DiveTeam/battery/esp32_firmware/control/docs/Bluetooth-TTGO-wi-fi-wi-fi-ESP32-IPEX.jpg

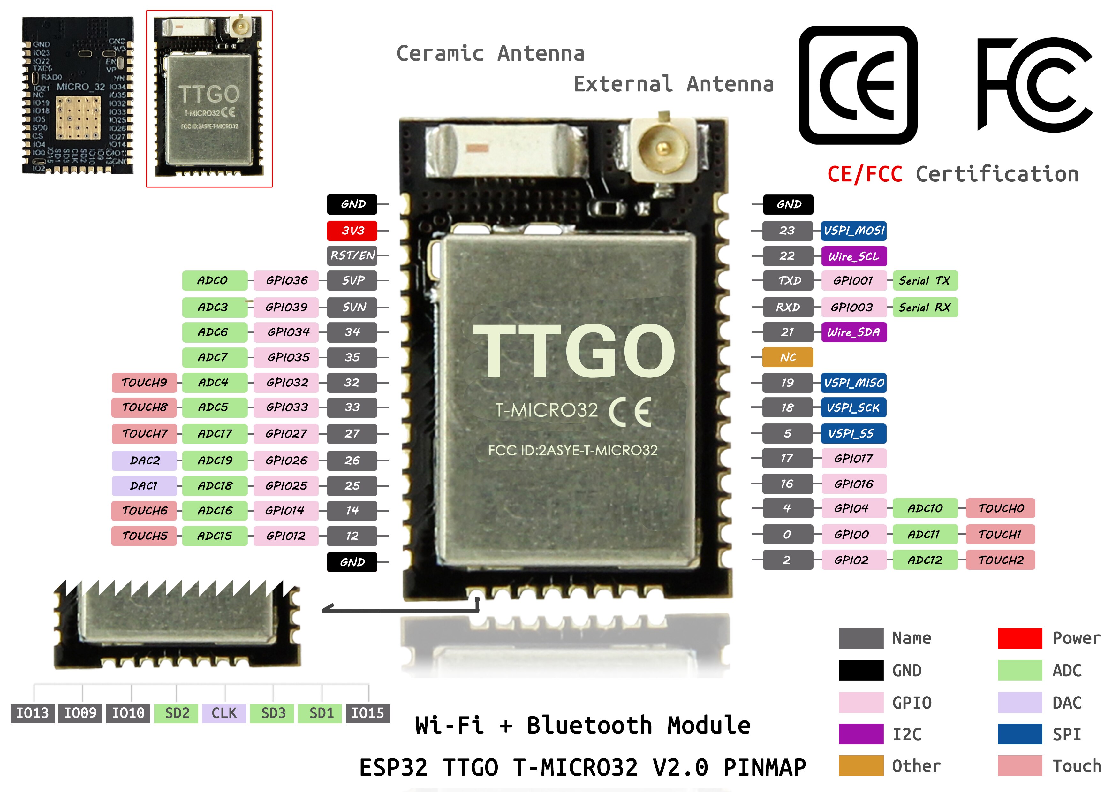
esp32_firmware/control/docs/Bluetooth-TTGO-wi-fi-wi-fi-ESP32-IPEX.jpg
