DiveTeam/battery/esp32_firmware/control/docs/ESP32_CH340G.png

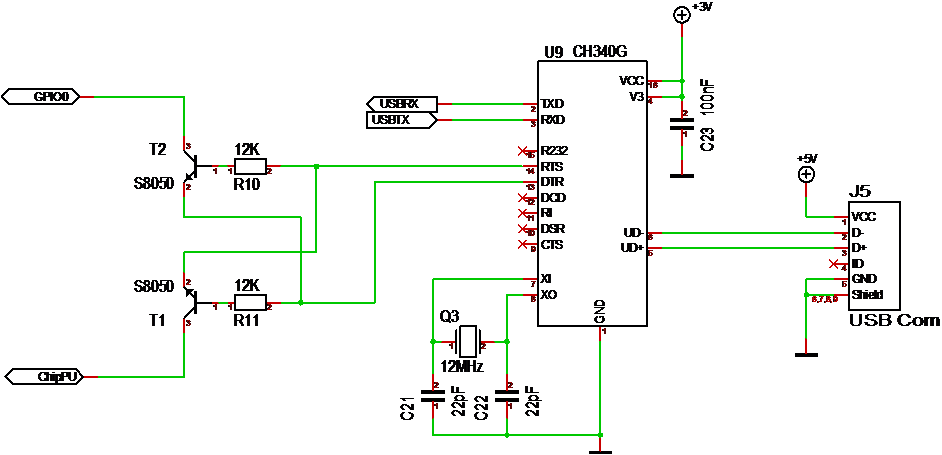
esp32_firmware/control/docs/ESP32_CH340G.png
