DiveTeam/battery/model/Батарея/батарея.SLDASM

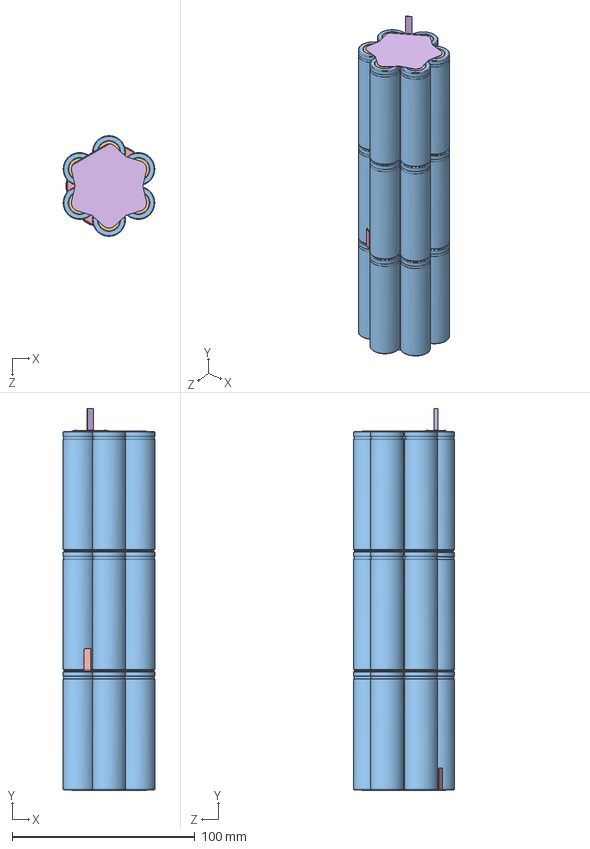
[picture p3: CAD file, 2020-10-05]
model/Батарея/батарея.SLDASM
50.0 x 208.8 x 55.0 mm
battery terminal - x 21
battery washer x 21
battery case x 21
battery terminal + x 21
контакт-1 x 5
контакт-2
