DiveTeam/battery/model/Гермоввод/гермоввод.SLDASM

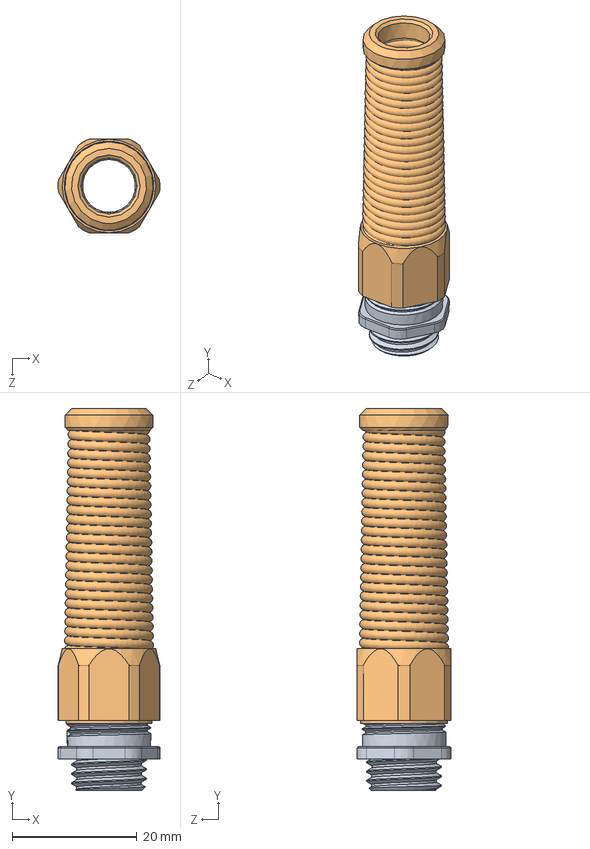
[picture p4: CAD file, 2020-10-05]
model/Гермоввод/гермоввод.SLDASM
16.4 x 61.2 x 15.0 mm
основание
гайка
