DiveTeam/battery/model/Кнопка/кнопка.SLDASM

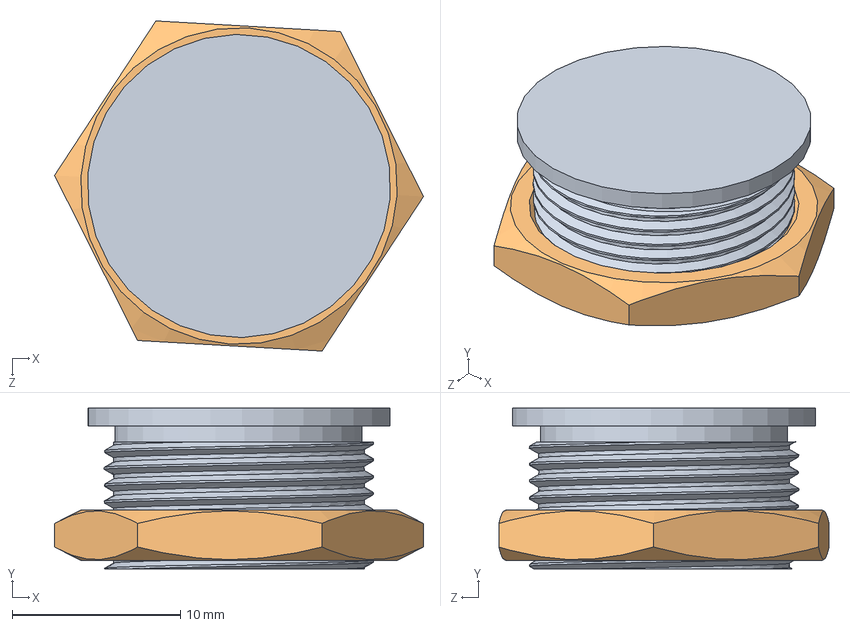
[picture p5: CAD file, 2020-10-05]
model/Кнопка/кнопка.SLDASM
21.9 x 9.55 x 19.6 mm
кнопка-корпус
кнопка-гайка
кнопка-заливка
