DiveTeam/battery/model/pan cross head_am.sldprt

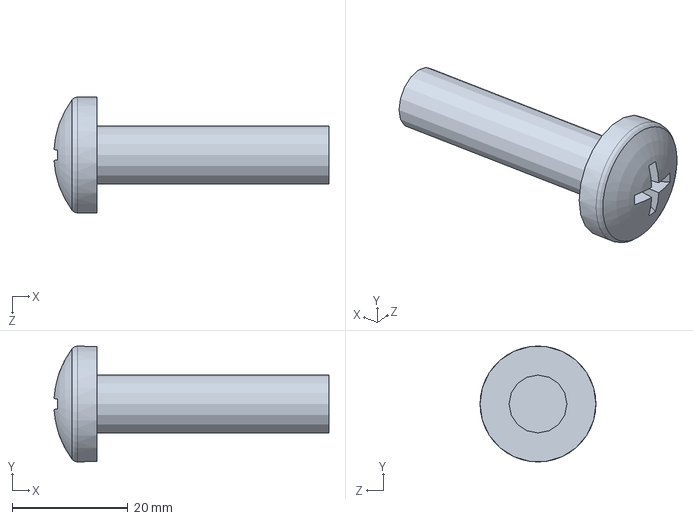
[picture p6: CAD file, 2020-10-05]
model/pan cross head_am.sldprt
47.4 x 20.0 x 20.0 mm
