DiveTeam/battery/model/Батарея/ncr18650b/battery terminal +.SLDPRT

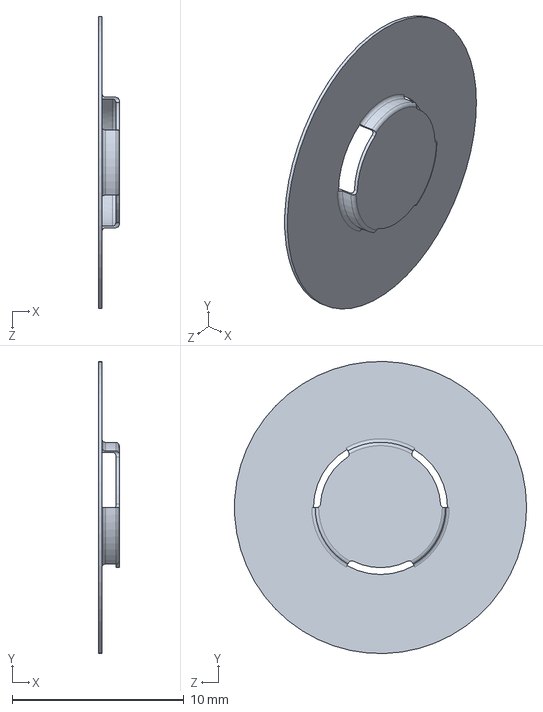
[picture p7: CAD file, 2020-10-05]
model/Батарея/ncr18650b/battery terminal +.SLDPRT
1.20 x 17.0 x 17.0 mm
