DiveTeam/battery/model/Батарея/контакт-2.SLDPRT

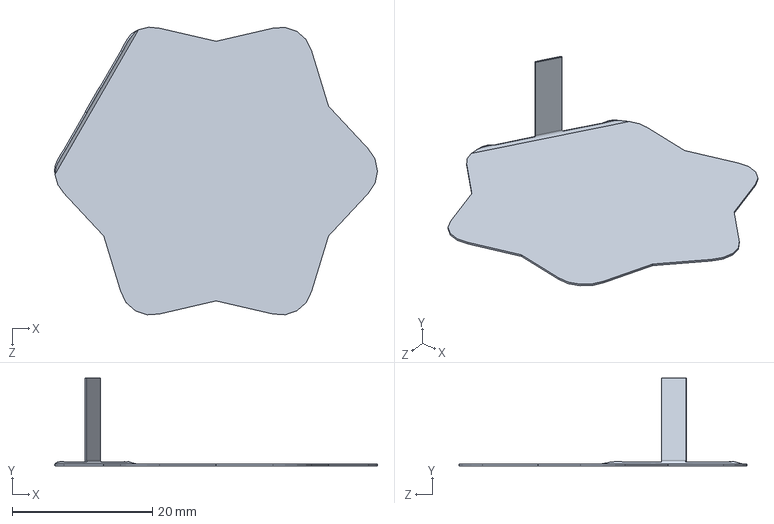
[picture p8: CAD file, 2020-10-05]
model/Батарея/контакт-2.SLDPRT
46.0 x 12.5 x 41.0 mm
