DiveTeam/battery/model/Гермоввод/гайка.SLDPRT

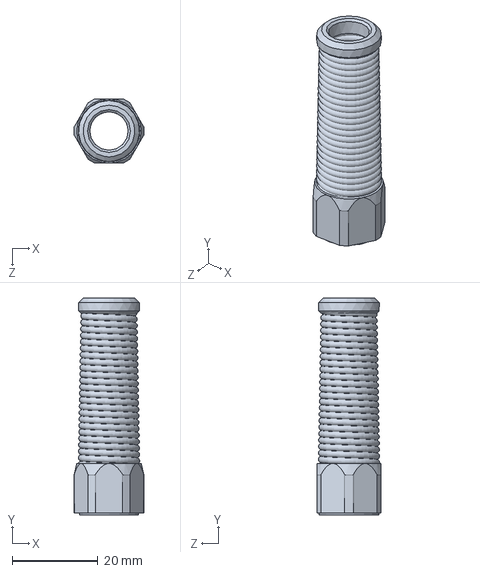
[picture p9: CAD file, 2020-10-05]
model/Гермоввод/гайка.SLDPRT
16.3 x 50.5 x 15.0 mm
