DiveTeam/battery/model/Кнопка/кнопка-корпус.SLDPRT

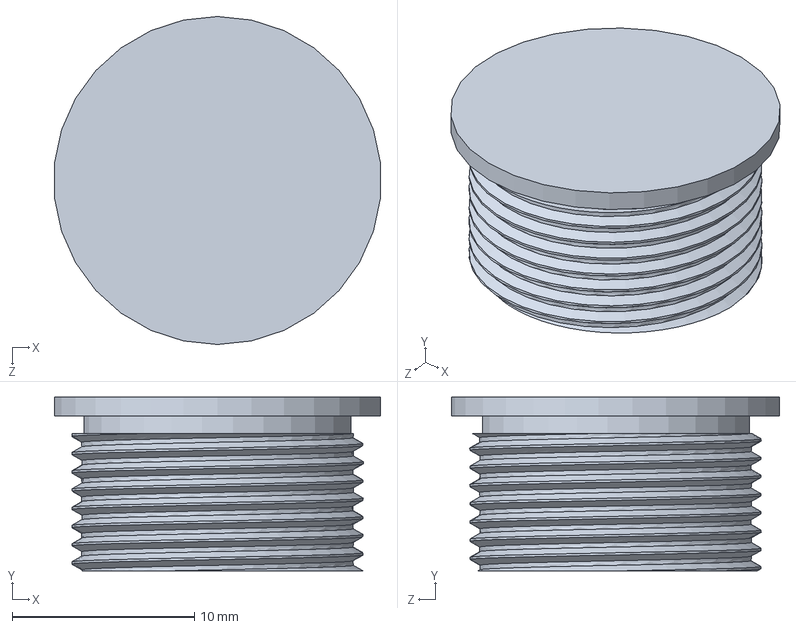
[picture p10: CAD file, 2020-10-05]
model/Кнопка/кнопка-корпус.SLDPRT
17.9 x 9.55 x 18.0 mm
