DiveTeam/battery/model/Крепёж/болт.SLDPRT

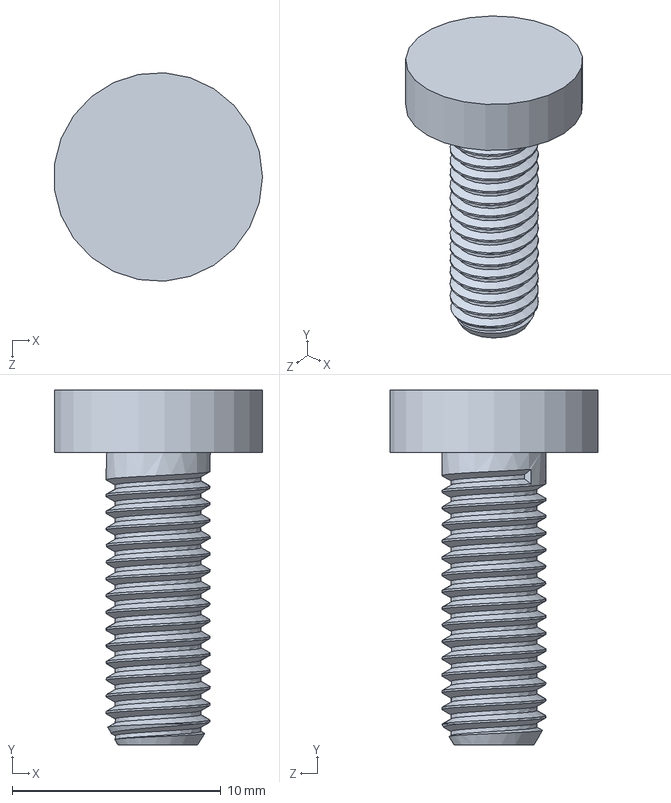
[picture p11: CAD file, 2020-10-05]
model/Крепёж/болт.SLDPRT
9.96 x 17.0 x 9.98 mm
