DiveTeam/battery/model/Пластик/нижняя крышка.SLDPRT

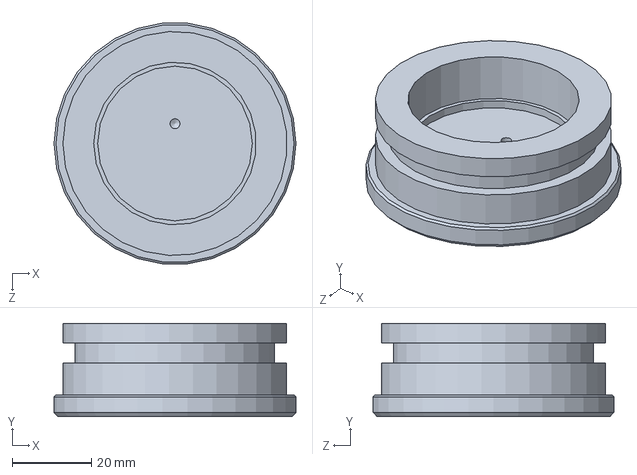
[picture p12: CAD file, 2020-10-05]
model/Пластик/нижняя крышка.SLDPRT
61.0 x 23.5 x 60.7 mm
