DiveTeam/battery/model/Платы/плата-кнопки.SLDPRT

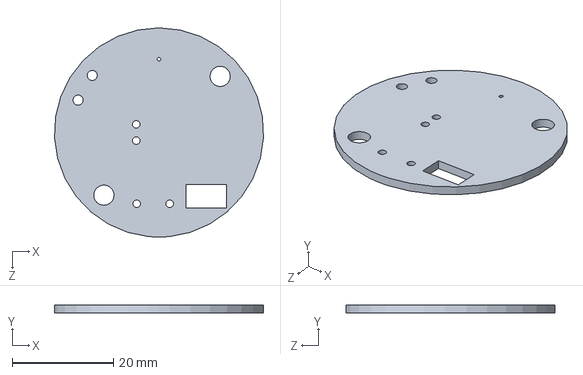
[picture p13: CAD file, 2020-10-05]
model/Платы/плата-кнопки.SLDPRT
41.3 x 1.60 x 41.4 mm
