DiveTeam/battery/model/EO-корд-корпус.SLDPRT

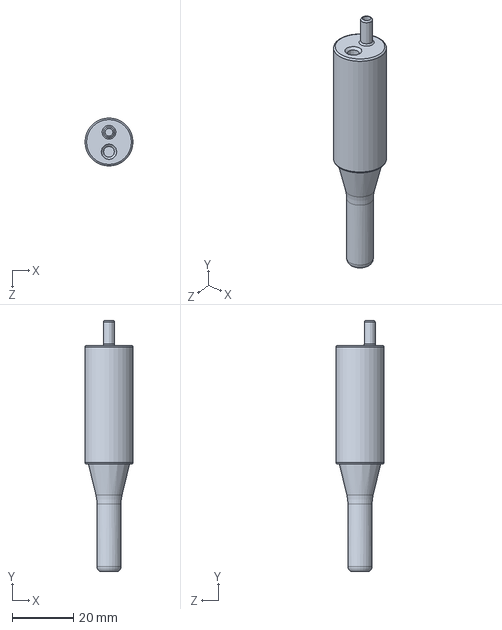
[picture p14: CAD file, 2020-10-05]
model/EO-корд-корпус.SLDPRT
15.6 x 81.7 x 15.6 mm
