DiveTeam/battery/model/Батарея/ncr18650b/battery case.SLDPRT

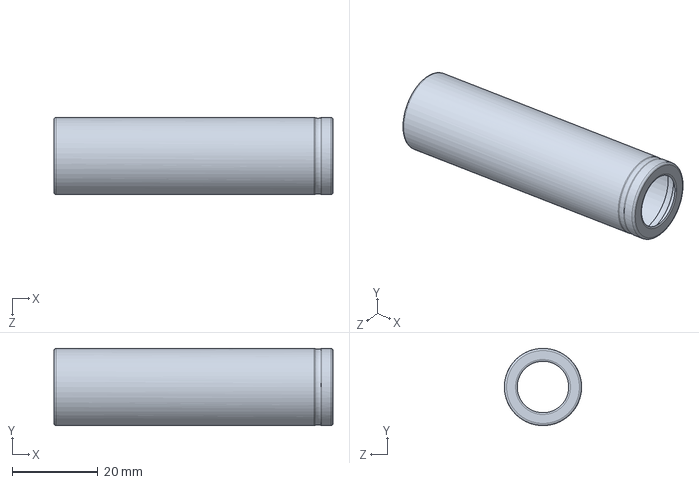
[picture p15: CAD file, 2020-10-05]
model/Батарея/ncr18650b/battery case.SLDPRT
65.0 x 18.0 x 18.0 mm
