DiveTeam/battery/model/Гермоввод/основание.SLDPRT

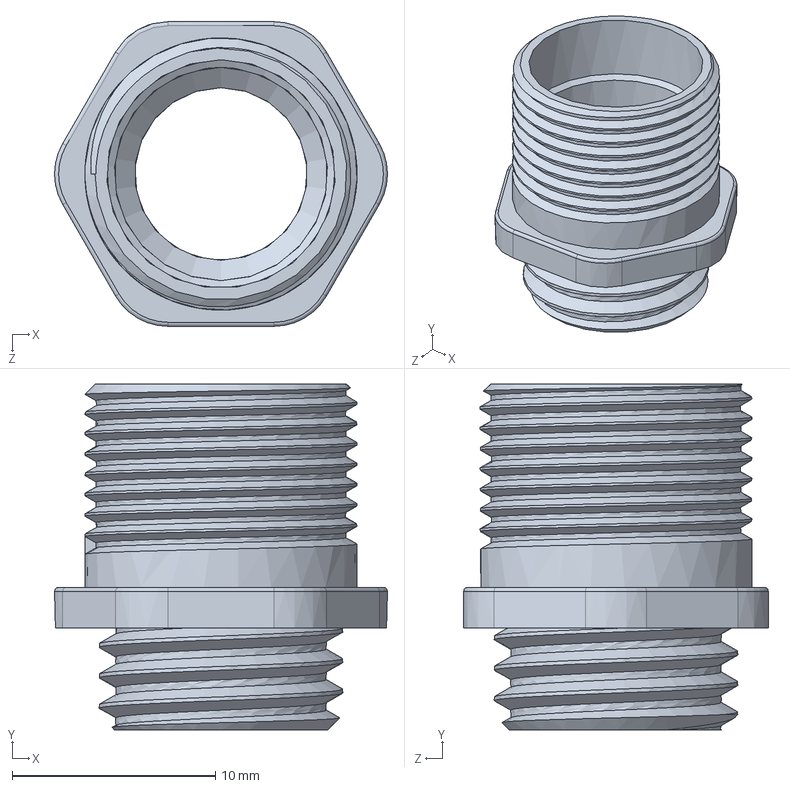
[picture p16: CAD file, 2020-10-05]
model/Гермоввод/основание.SLDPRT
16.4 x 17.0 x 15.0 mm
