DiveTeam/battery/model/Кнопка/кнопка-заливка.SLDPRT

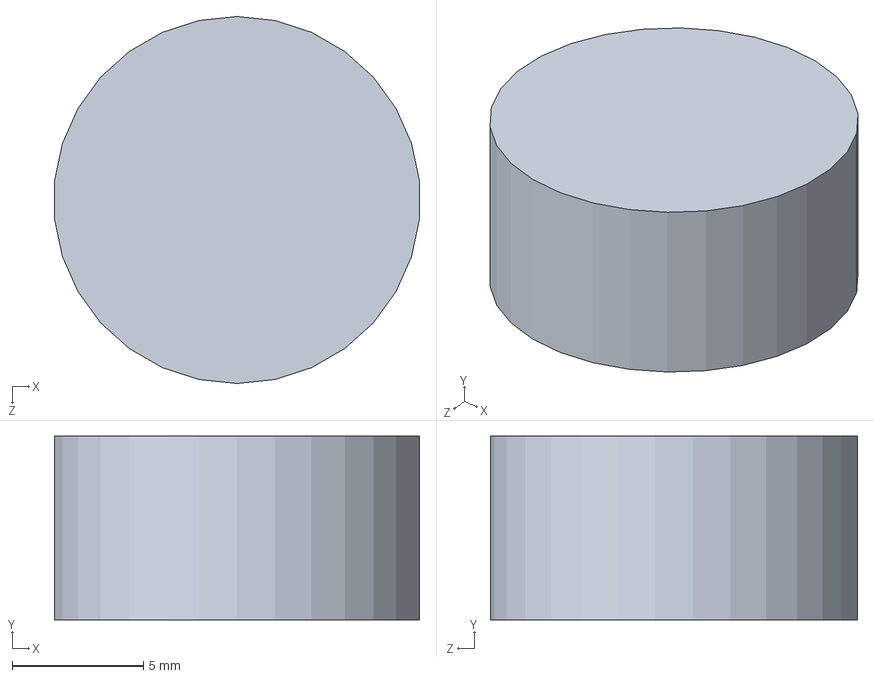
[picture p17: CAD file, 2020-10-05]
model/Кнопка/кнопка-заливка.SLDPRT
13.9 x 7.00 x 14.0 mm
