DiveTeam/battery/model/Крепёж/гужон.SLDPRT

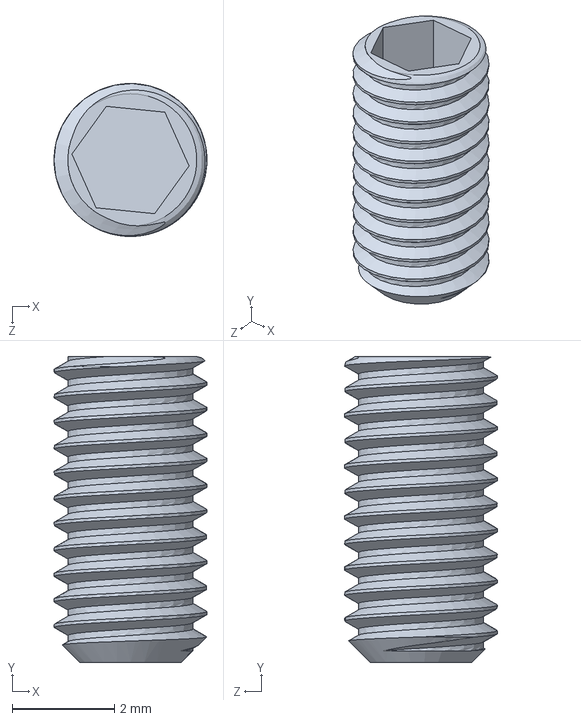
[picture p18: CAD file, 2020-10-05]
model/Крепёж/гужон.SLDPRT
3.00 x 6.00 x 3.00 mm
