DiveTeam/battery/model/Пластик/верхняя крышка.SLDPRT

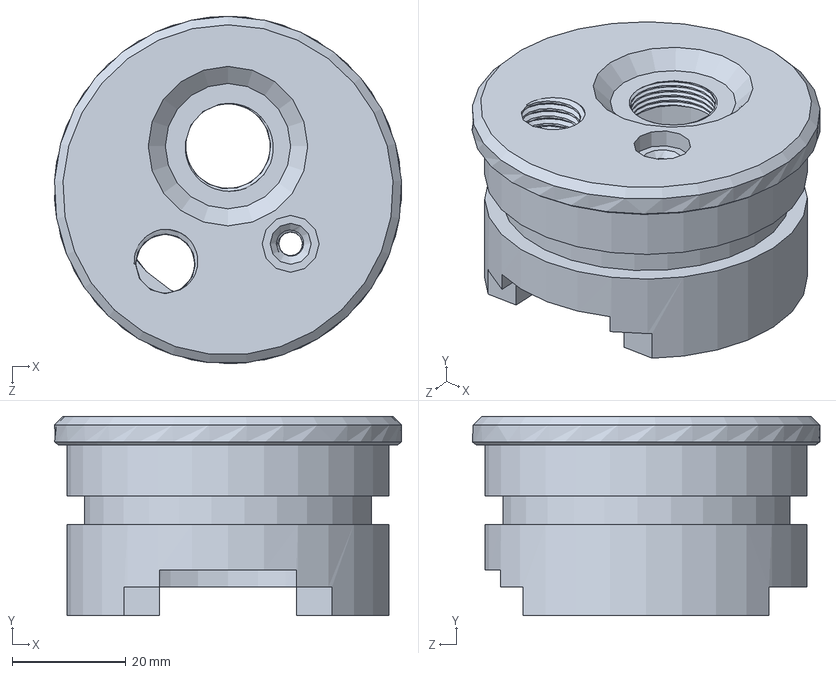
[picture p19: CAD file, 2020-10-05]
model/Пластик/верхняя крышка.SLDPRT
60.9 x 35.0 x 61.0 mm
