DiveTeam/battery/model/Платы/плата-защита.SLDPRT

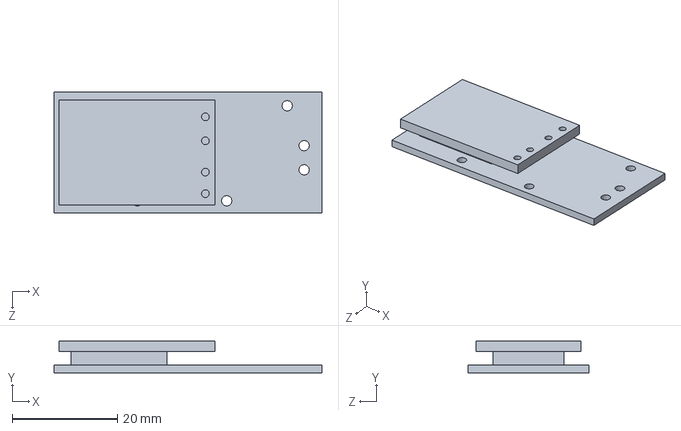
[picture p20: CAD file, 2020-10-05]
model/Платы/плата-защита.SLDPRT
51.0 x 6.00 x 23.0 mm
