DiveTeam/battery/model/Батарея/контакт-1.SLDPRT

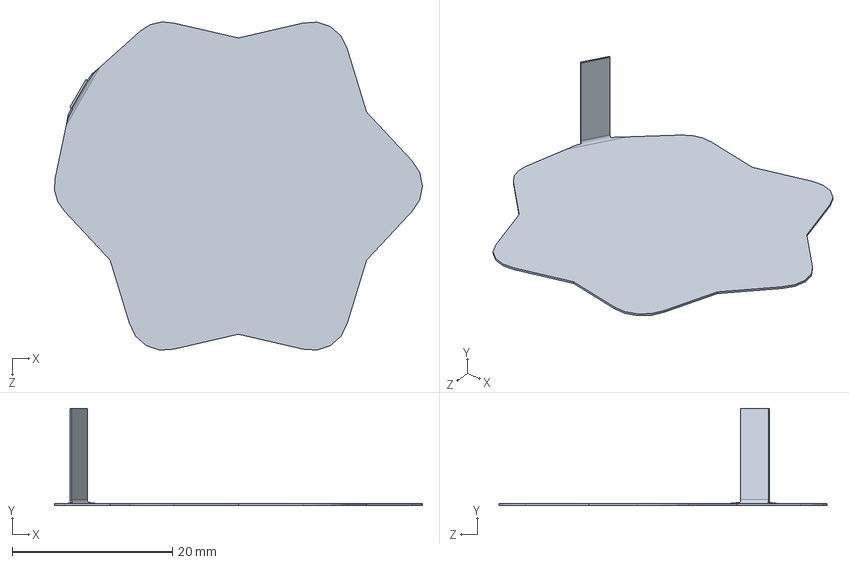
[picture p21: CAD file, 2020-10-05]
model/Батарея/контакт-1.SLDPRT
46.0 x 12.2 x 41.0 mm
