DiveTeam/battery/model/Кнопка/кнопка-гайка.SLDPRT

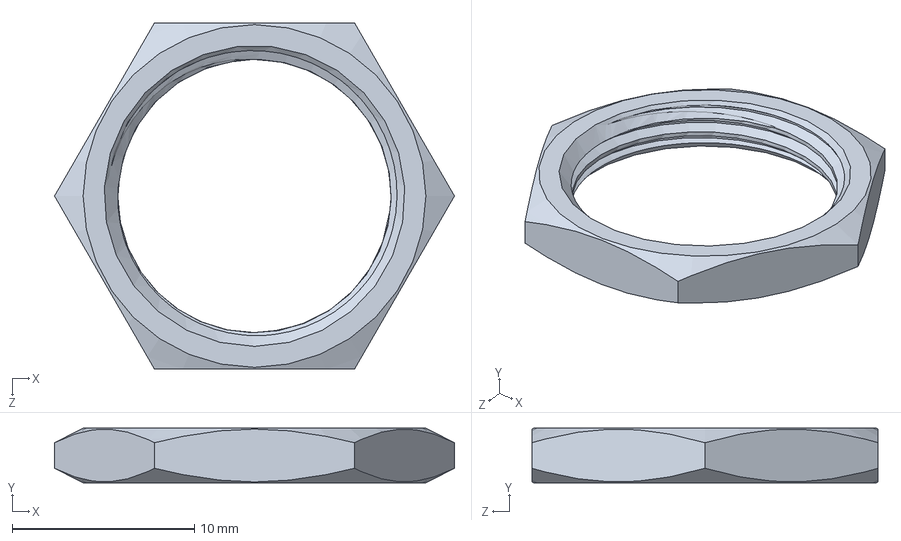
[picture p22: CAD file, 2020-10-05]
model/Кнопка/кнопка-гайка.SLDPRT
21.9 x 3.00 x 19.0 mm
