DiveTeam/battery/model/Крепёж/шпилька.SLDPRT

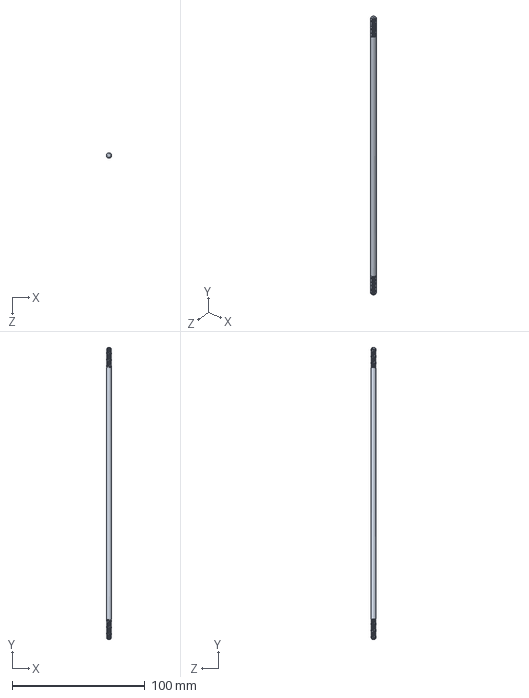
[picture p23: CAD file, 2020-10-05]
model/Крепёж/шпилька.SLDPRT
4.00 x 220.0 x 4.00 mm
