DiveTeam/battery/model/Пластик/крышка батареи.SLDPRT

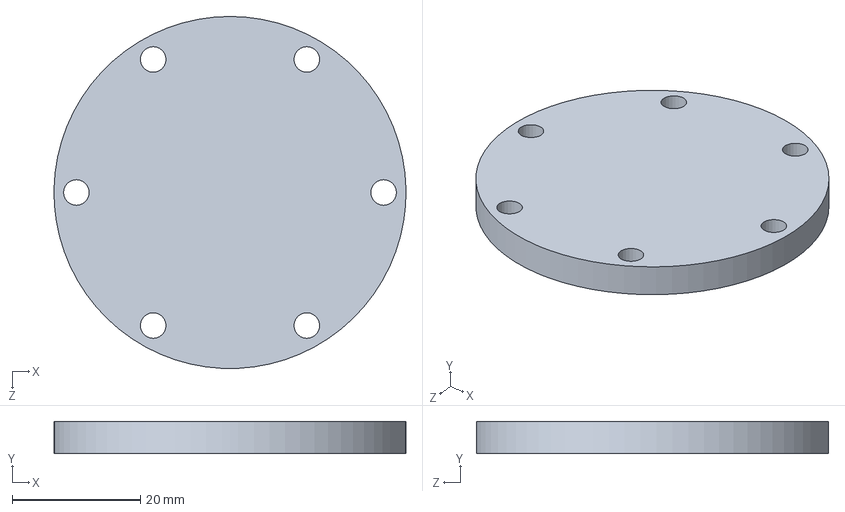
[picture p24: CAD file, 2020-10-05]
model/Пластик/крышка батареи.SLDPRT
55.0 x 5.00 x 55.0 mm
