DiveTeam/battery/model/труба.SLDPRT

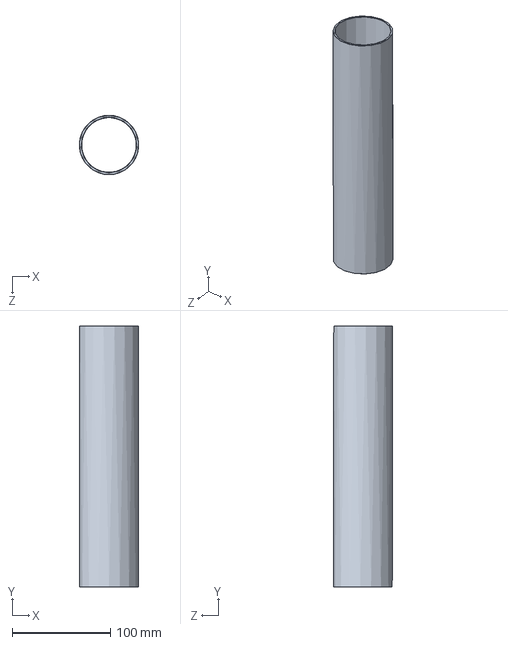
[picture p25: CAD file, 2020-10-05]
model/труба.SLDPRT
60.1 x 265.0 x 60.4 mm
