DiveTeam/battery/model/pan slot head_am.sldprt

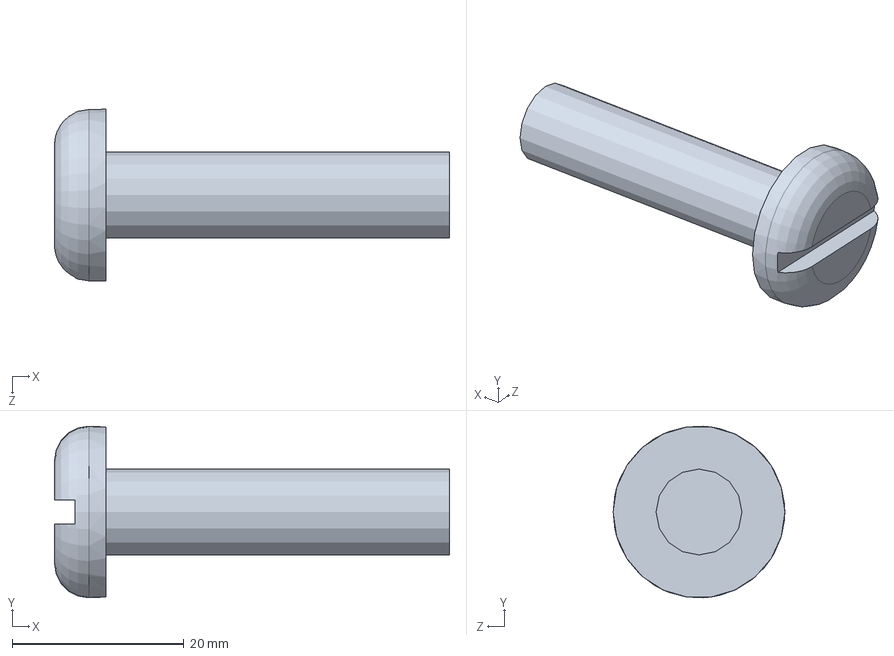
[picture p26: CAD file, 2020-10-05]
model/pan slot head_am.sldprt
46.0 x 20.0 x 20.0 mm
