DiveTeam/battery/model/Развертка - контакт-1.DXF

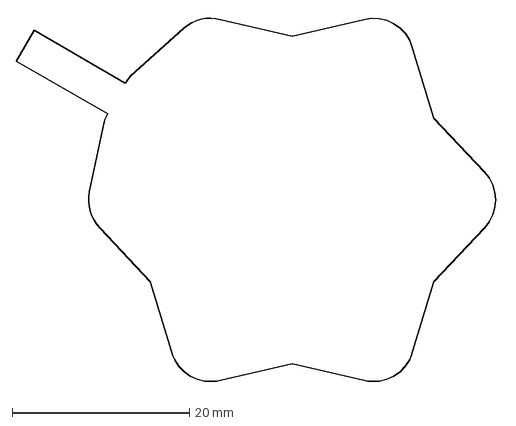
[picture p27: CAD file, 2020-10-05]
model/Развертка - контакт-1.DXF
54.6 x 41.8 mm
