DiveTeam/battery/model/Развертка - контакт-2.DXF

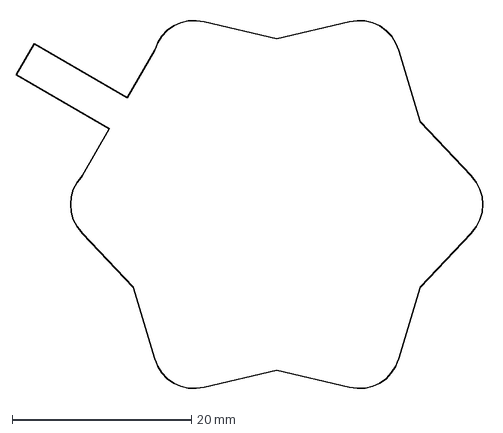
[picture p28: CAD file, 2020-10-05]
model/Развертка - контакт-2.DXF
52.5 x 42.0 mm
