DiveTeam/battery/model/EO-корд.SLDASM

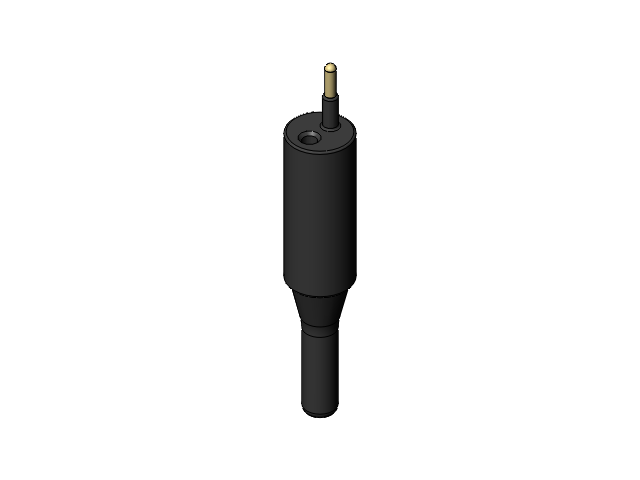
[picture p29: CAD file, 2020-10-05]
model/EO-корд.SLDASM
Копия EO-корд^EO-корд
Деталь7^EO-корд
Деталь8^EO-корд
