DiveTeam/battery/(list of files, cad)

Other CAD files:
model/Harness_3-Канистра.sldasm
model/Harness_1-Канистра.sldasm
model/Cable_1-Канистра.sldasm
model/Harness_2-Канистра-001.sldasm
model/Harness_2-Канистра.sldasm
model/18650 battery.SLDASM
model/hex nut style 2_am.sldprt
model/Батарея/ncr18650b/18650 battery.SLDASM
model/Батарея/ncr18650b/battery terminal -.SLDPRT
model/Батарея/ncr18650b/battery washer.SLDPRT
model/Пластик/крышка батареи.SLDDRW
model/Пластик/нижняя крышка.SLDDRW
