DiveTeam/battery/esp32_firmware/test/src/README.md

К контроллер канистры сначала надо залить именно этот код.
Подякок:

- припаиваем к плате кнопку
- припаиваем разъём аккумулятора (BATT+ и BATT-)
- припаиваем временные провода питания (OUT+ и OUT-) и подключаем их к БП (12.6В) и к мультиметру. БП пока не включать
- 5-ти пиновый разъ\м подключаем к UART-преобразователю. RX, TX, GND. Преобразователь должен быть в режиме 3.3В. Преобразователь - в USB

- Замыкаем вместе 3 и 5 провода 5-ти контактного разъёма (земля и gpio0) и включаем БП (12В)
- зашиваем прошивку.
- отключаем 5-й провод от земли, выключаем БП

- Подключить батарею (6-ти пиновый разъём, потом силовой). Убедиться, что не идёт дым %)
- открываем serial monitor (115200)
- разворачиваем к себе конструкцию так, чтобы можно было нажимать на кнопку, дотрагиваться до платы протечки, видеть светодиод платы и иметь возможность быстро подключить/отключить БП
- включаем с сразу выключаем БП, выполняем инструкции по проверке в консоли. если какой-то этам не работает - ищем и устранем причины
