DiveTeam/battery/(threads)

Thread 1 (2020-10-02):

Режим частичной мощности

dmitryshagin, 2020-10-02:
Сделать выключение канистры в 2 этапа:
1) понижение мощности до заданного порога
2) полное выключение

Первое понижение сопроводить виброоткликом.
В режиме пониженной мощности цвет диода не меняется, но диод начинает мигать (частота - что-то среднее между аварией по протечке и зарядкой)
Этот режим должен настраиваться с телефона (% от максимальной мощности).
Возможность входа в этот режима должна быть отключаема (с телефона) (если использовать канистру для фонаря)

На выходе - низкоскоростой ШИМ (типа 5-10 секунд период ШИМа)

Thread 2 (2020-10-03):

Автоматическое отключение по показаниям BMS, до сторой ступени защиты

dmitryshagin, 2020-10-03:
Выключать канистру программно при 1-2% SOC.
Чтобы избежать ложных выключений - выключать только при отсутствии зарядника и с какой-то задержкой. Например, 10 если секунд с момента включения зарядник не подключен и SOC < 2% - выключиться.
Это прилично продлит жизнь аккумулятору, на оставшихся 200мА канистра до полной разрядки сможет пролежать примерно 3-4 месяца до ухода в глубокий сон и полного отключения

Thread 3 (2020-10-05):

Повышенное потребление в выключенном состоянии

dmitryshagin, 2020-10-05:
С прошивкой 0.1.2 ESP жрёт 600мкА в выключенном состоянии. При этом, если не включать блутус, то при выключении потребление на порядок меньше. Нужно посмотреть код деинициализации BLE (он вызывается и сейчас, возможно нужны дополнительные телодвижения)

dmitryshagin, 2020-10-05:
Possible solution: https://github.com/nkolban/esp32-snippets/issues/354
